surjithbs17/AntiTheftVehicleTrackingSystem/Project files/Pictures/StepperMotor_Project peripherals.jpg

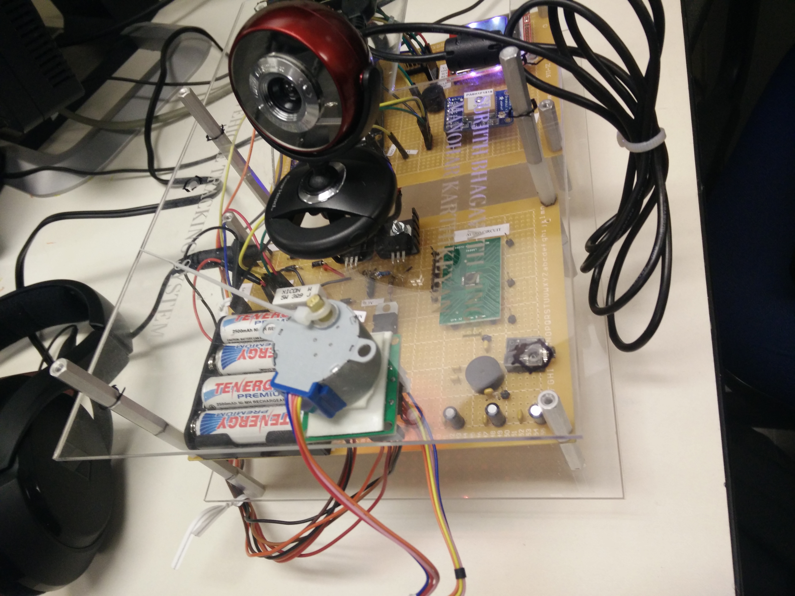
Project files/Pictures/StepperMotor_Project peripherals.jpg
