surjithbs17/AntiTheftVehicleTrackingSystem/README.md

# AntiTheftVehicleTrackingSystem
This project contains code developed by two students at U. of Colorado at Boulder to develop a DIY prototype of Anti theft vehicle tracking system.  Please use at your own risk. We are sharing so that other researchers and developers can recreate our results and make suggestions to improve and extend the project over time.
