surjithbs17/AntiTheftVehicleTrackingSystem/Project files/Presentations/Demo_F15_BhagavathSingh_Karthikeyan_AntiTheft.pptx

## Anti Theft Vehicle Tracking system ECEN 5613

Manohar Karthikeyan, Surjith Bhagavath Singh 12/6/2015 ESD Fall 2015 Anti Theft Vehicle Tracking system

## Block Diagram

Power Circuit
(Rectifier and Voltage Regulator(9V))

Battery Charging circuit

Voltage Regulatory Circuit(5V,3.3V,1.8V)

Audio Circuit
(TLV320AIC3204)

GPS Module

USB Camera

Wifi Module

Buzzer

BeagleBone black

Motor Circuit

Graphical LCD (Nokia 5110)

Manohar Karthikeyan, Surjith Bhagavath Singh 12/6/2015 ESD Fall 2015 Anti Theft Vehicle Tracking system

Power Lines

Data Lines

## Challenges faced

- Interfacing USB camera for required specifications (i.e 23 fps)
- Designing UPS circuit
- Drivers for Graphical LCD and GPS
- Designing Audio Circuit
- Integrating all the modules and creating a web page.

Things learnt

Developing modules with Python
User space driver in Linux
Analog circuit design
Web server using Python (flask) and HTML

Manohar Karthikeyan, Surjith Bhagavath Singh 12/6/2015
ESD Fall 2015 Anti Theft Vehicle Tracking system

## Thank You!!
