surjithbs17/AntiTheftVehicleTrackingSystem/Project files/Pictures/gps2.png

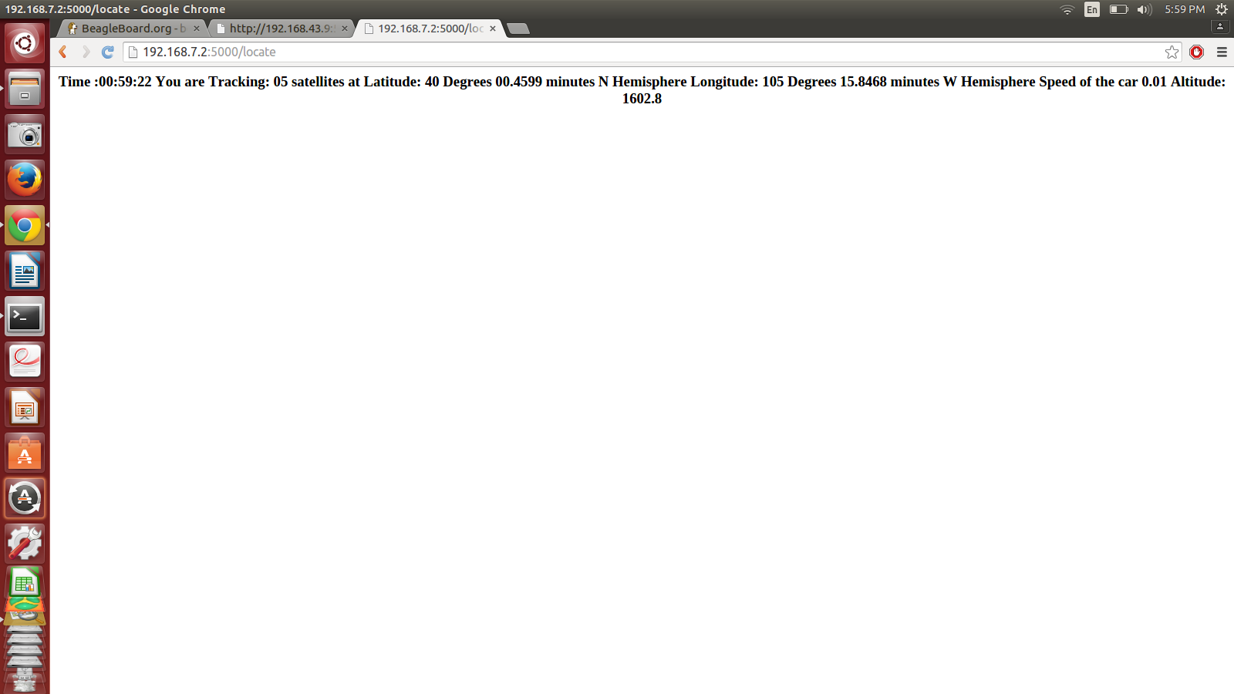
Project files/Pictures/gps2.png
