surjithbs17/AntiTheftVehicleTrackingSystem/Project files/Pictures/wifi config.png

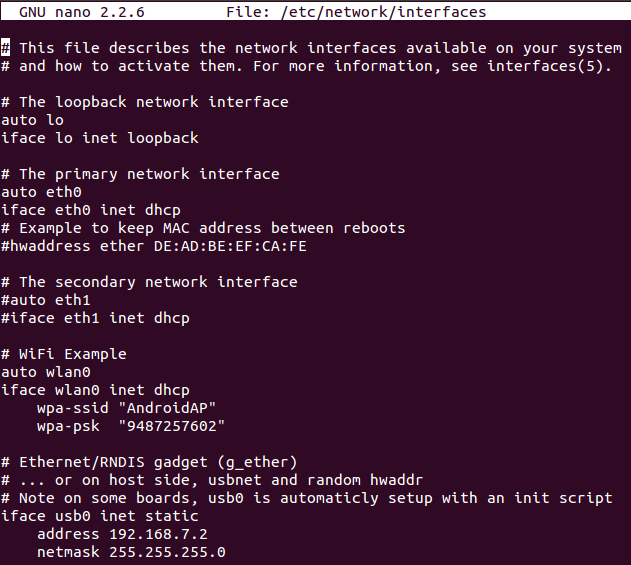
Project files/Pictures/wifi config.png
