surjithbs17/AntiTheftVehicleTrackingSystem/Project files/Pictures/wlan_ip_address.png

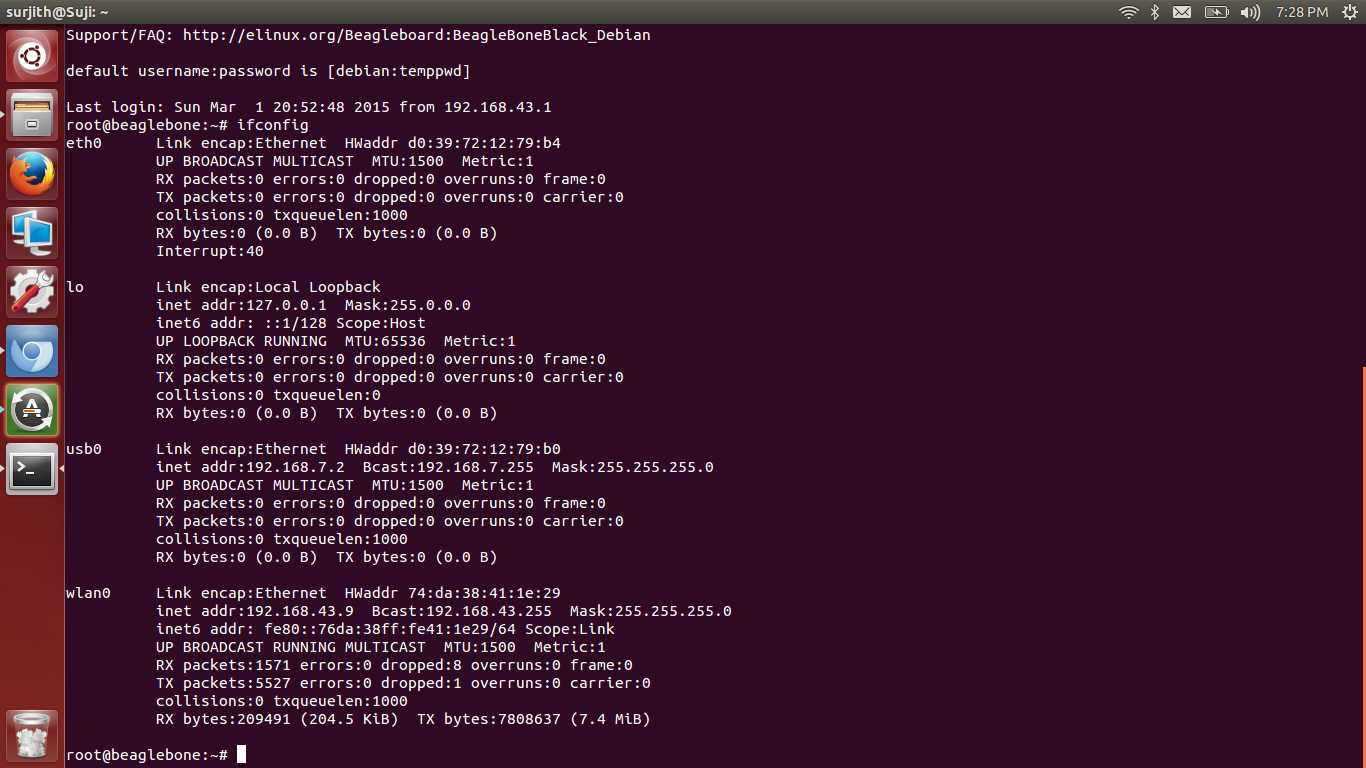
Project files/Pictures/wlan_ip_address.png
