surjithbs17/AntiTheftVehicleTrackingSystem/Project files/Schematics/Schematics_Project.pdf

A | A PWR GND

# POWER SUPPLY CIRCUIT

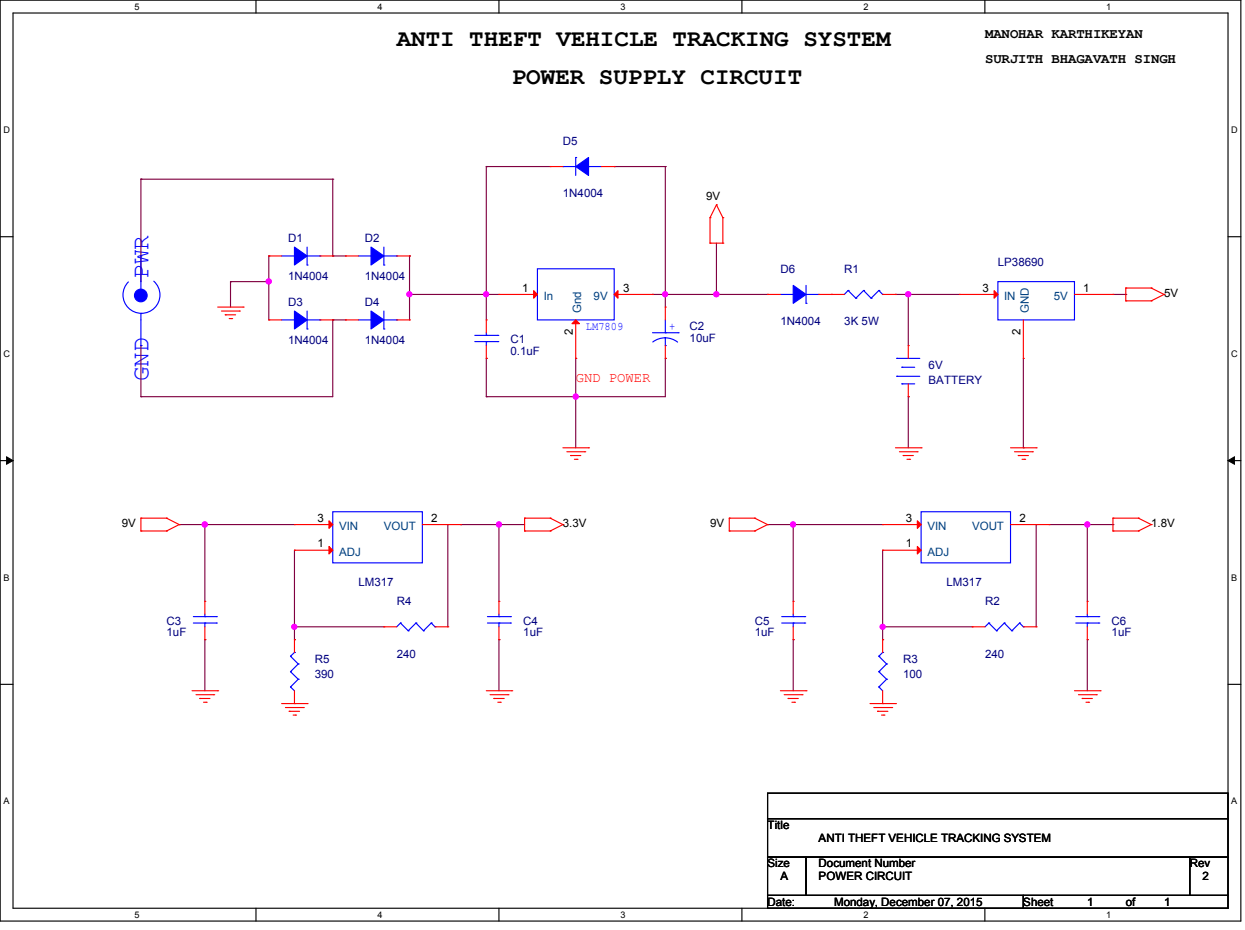
[picture p30: page 1]

ANTI THEFT VEHICLE TRACKING SYSTEM

# BEAGLEBONE AND OTHER PERIPERALS

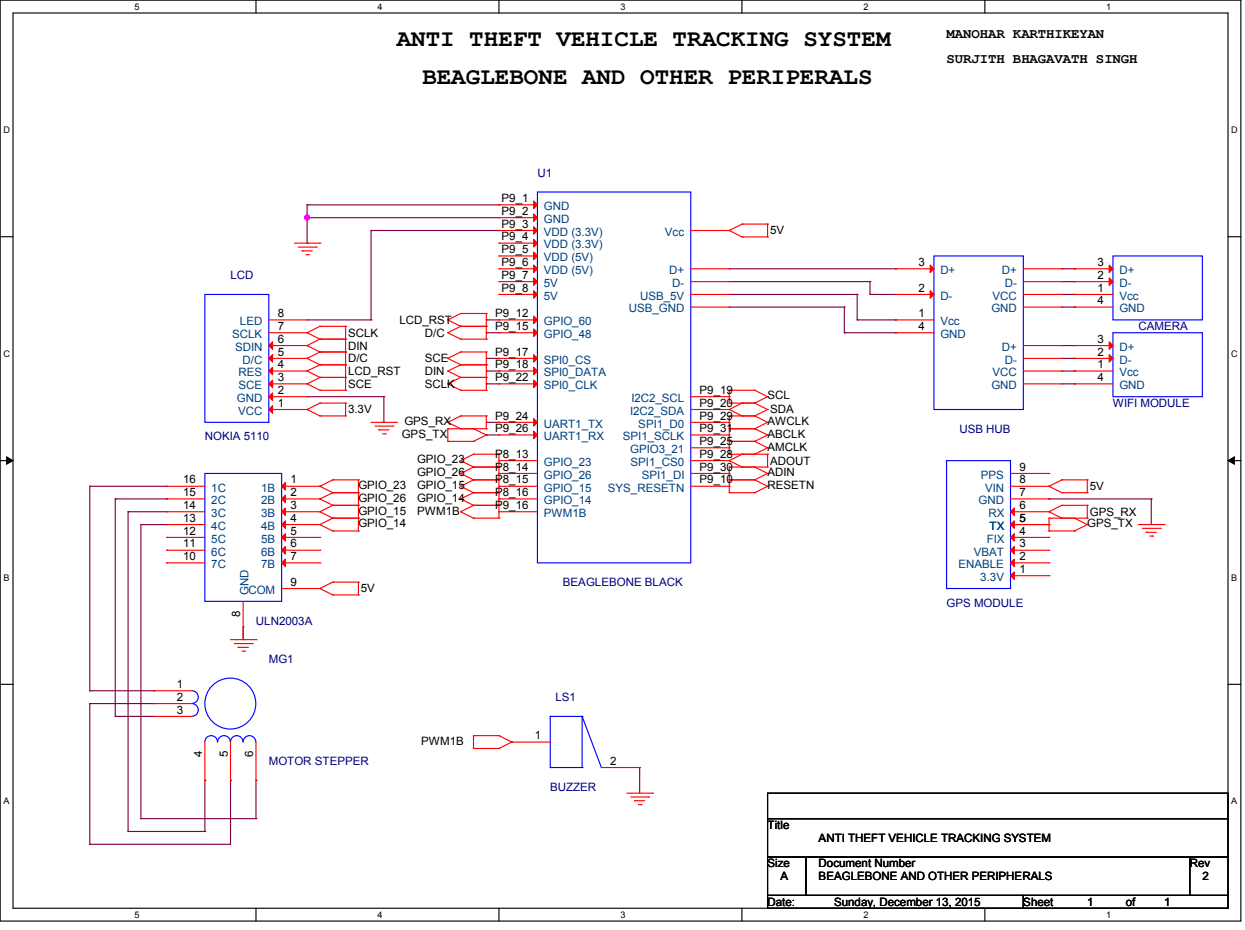
[picture p31: page 2]
DIN D/C LCD_RST SCE; DIN; SCE; LCD_RST; SCLK; GPS_RX; GPS_TX; GPIO_23 GPIO_26 GPIO_15 GPIO_14; PWM1B; SCL; RESETN; ADIN; AMCLK; ABCLK; AWCLK; SDA; ADOUT; Title; Size; Document Number; Rev; BEAGLEBONE AND OTHER PERIPHERALS; Sunday, December 13, 2015; ULN2003A; COM; GND 8; NOKIA 5110; LCD; VCC; GND; RES; SDIN; 6 SCLK; 7 LED; BUZZER; USB HUB; GND 4; Vcc 1; D+ D- VCC GND; BEAGLEBONE BLACK; GND P9_1 GND P9_2 VDD (3.3V) P9_3 VDD (3.3V) P9_4 VDD (5V) P9_5 VDD (5V) P9_6 5V P9_7 5V P9_8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

ANTI THEFT VEHICLE TRACKING SYSTEM

# AUDIO PROCESSING CIRCUIT

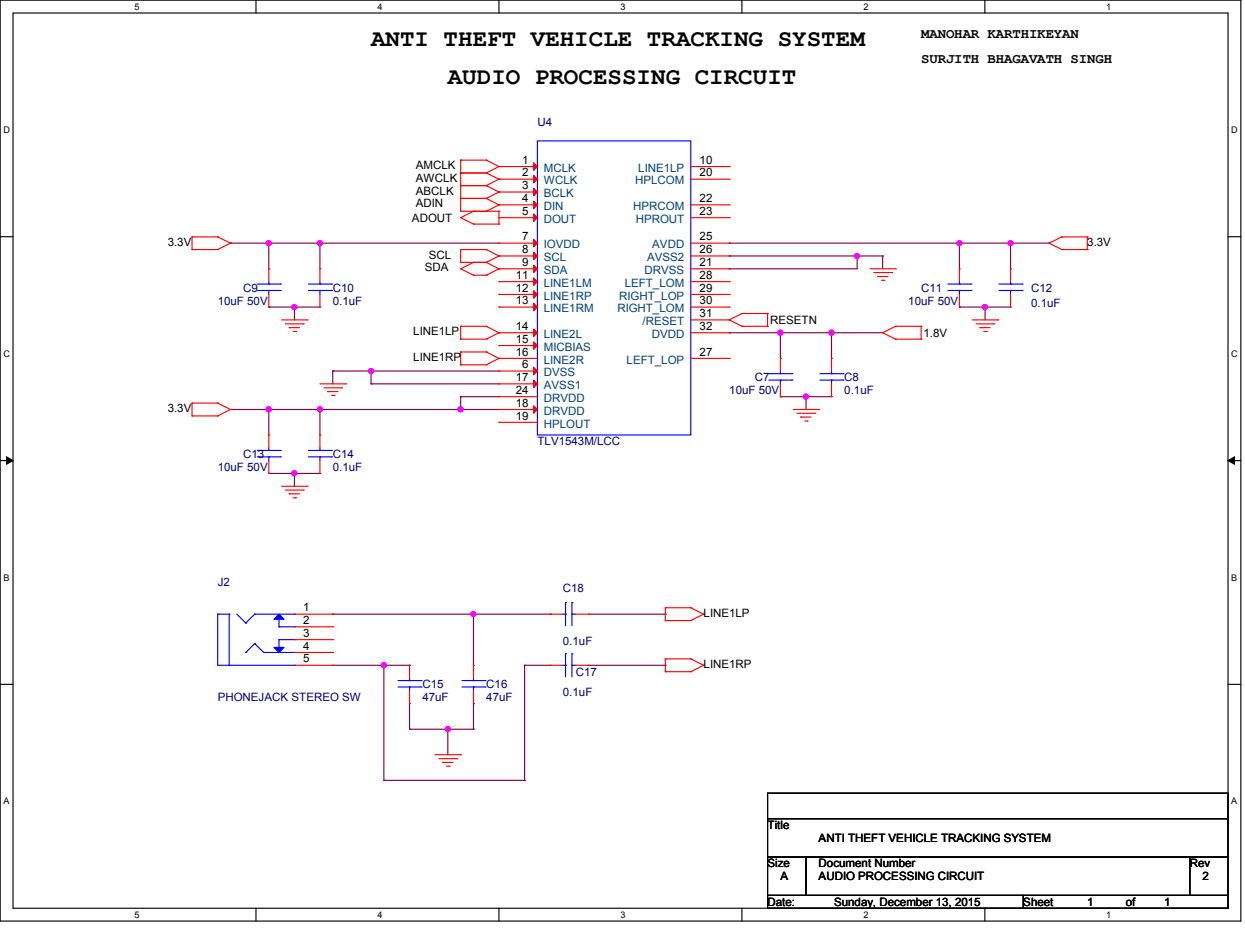
[picture p32: page 3]

ANTI THEFT VEHICLE TRACKING SYSTEM
