surjithbs17/AntiTheftVehicleTrackingSystem/(list of files, drawings)

Other design files:
Project files/Schematics/PROJECT_SCHEMATIC.DSN
Project files/Schematics/Project_schematic.opj
